FabLabKannai/fabbot/docs/img/fabbot_photo_top.jpg

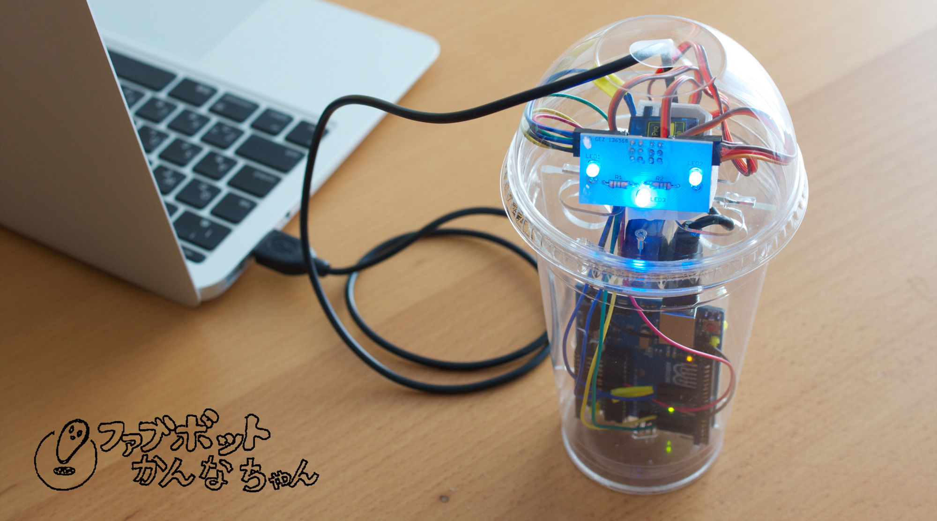
docs/img/fabbot_photo_top.jpg
