FabLabKannai/fabbot/frame/fabbot_frame_v3-1.pdf

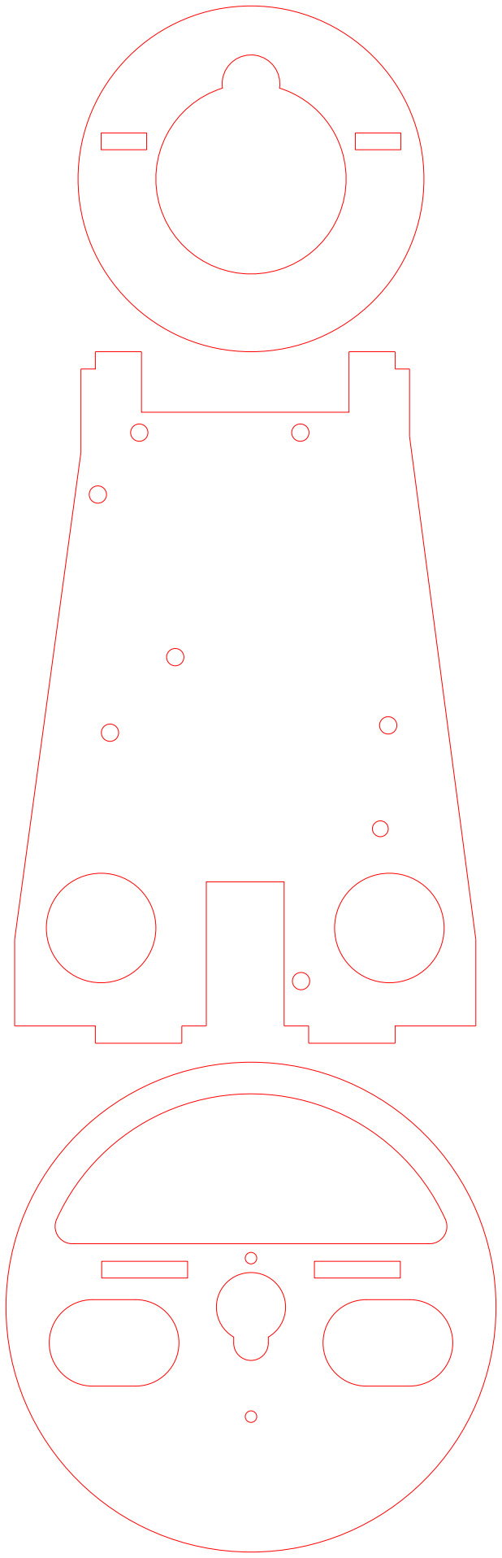
[picture p2: figure]
