FabLabKannai/fabbot/frame/fabbot_frame_v3.pdf

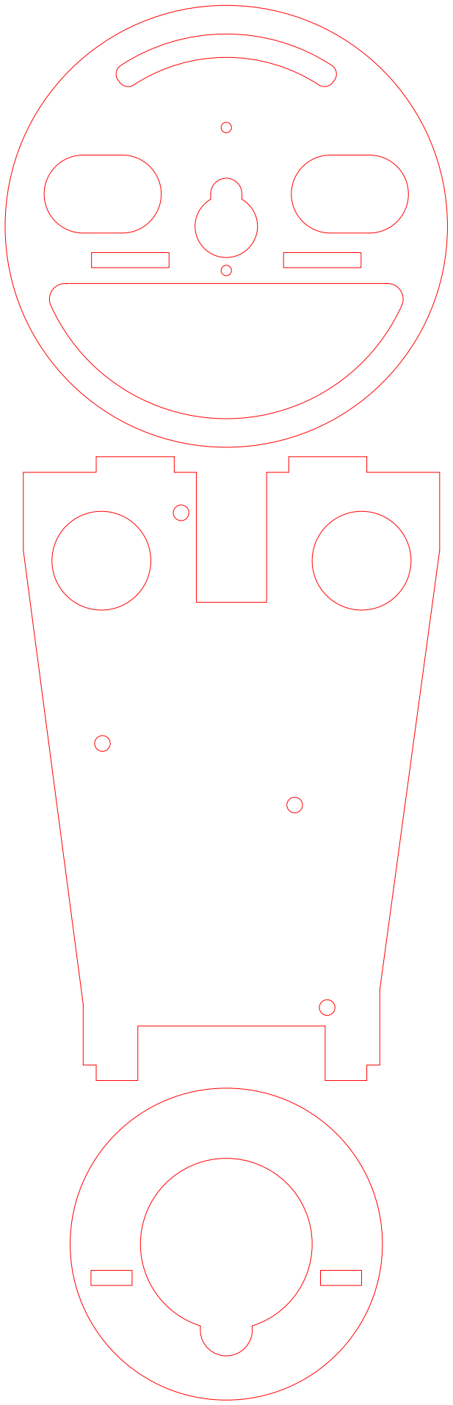
[picture p3: figure]
