FabLabKannai/fabbot/bracket/201412/bracket_for_replicator/bracket_A.stl

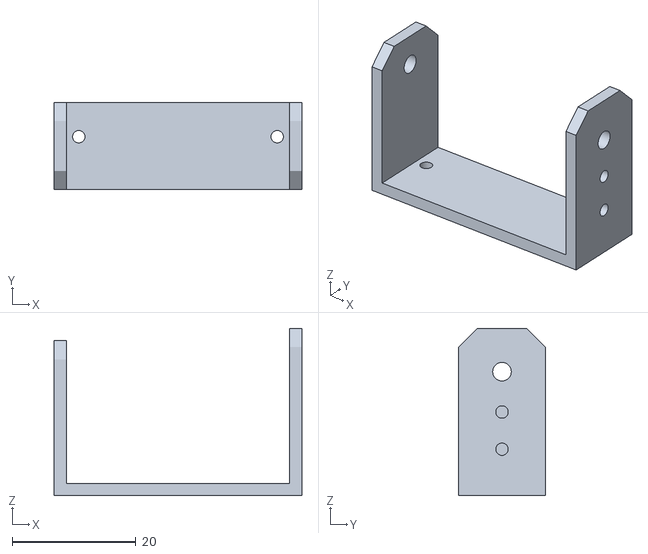
[picture p4: CAD file, 2014-11-28]
bracket/201412/bracket_for_replicator/bracket_A.stl
40.0 x 14.0 x 27.0
