FabLabKannai/fabbot/bracket/201505/speaker_case.stl

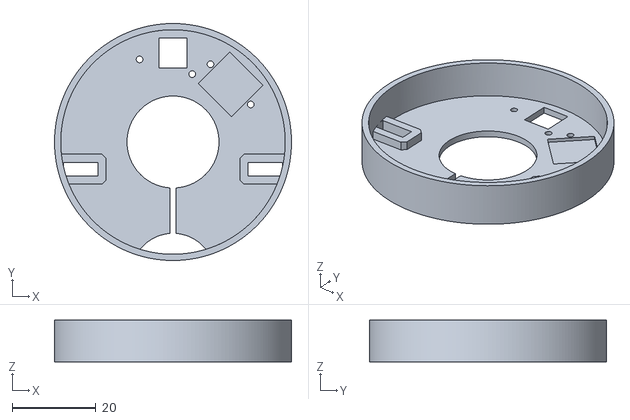
[picture p5: CAD file, 2015-05-09]
bracket/201505/speaker_case.stl
56.7 x 56.7 x 10.0
