FabLabKannai/fabbot/bracket/case.stl

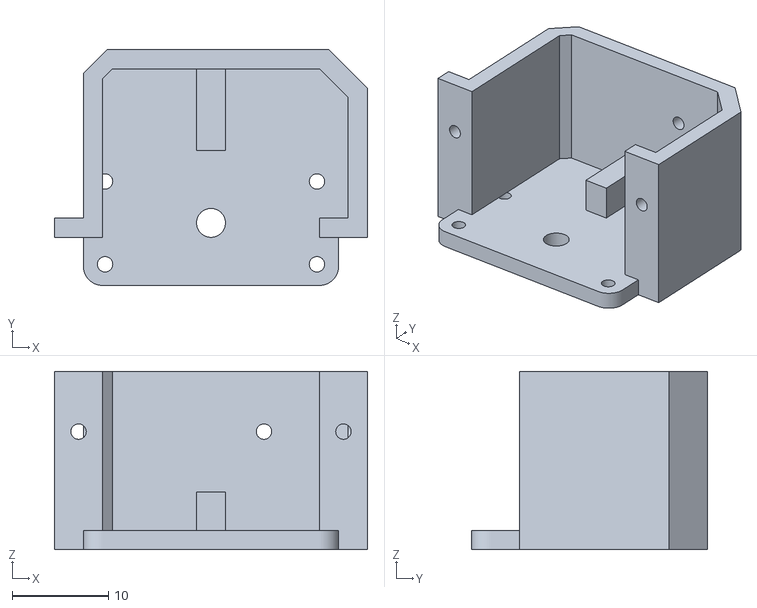
[picture p6: CAD file, 2015-09-20]
bracket/case.stl
32.5 x 24.5 x 18.5
