FabLabKannai/fabbot/speaker/speaker_case_L57ID_board.stl

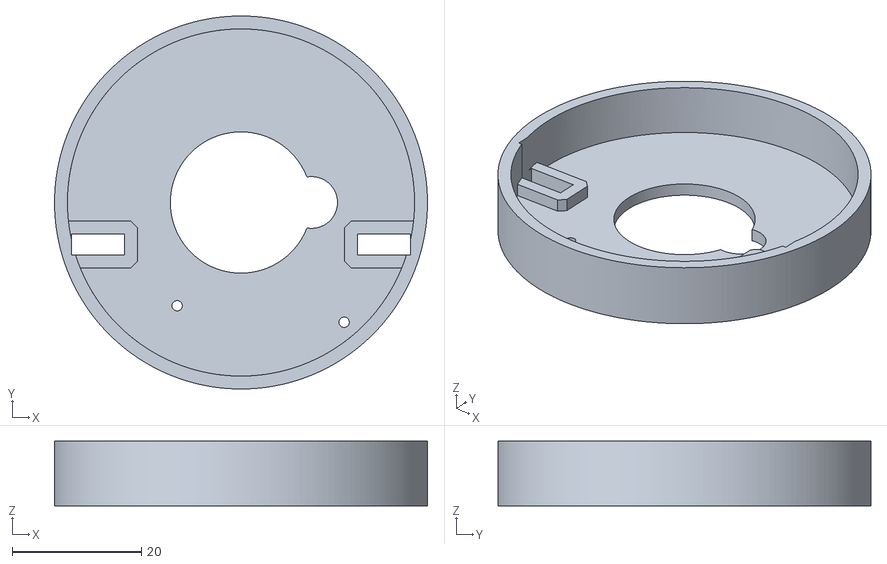
[picture p7: CAD file, 2015-09-20]
speaker/speaker_case_L57ID_board.stl
57.7 x 57.7 x 10.0
