FabLabKannai/fabbot/bracket/201412/bracket_for_replicator/bracket_B.stl

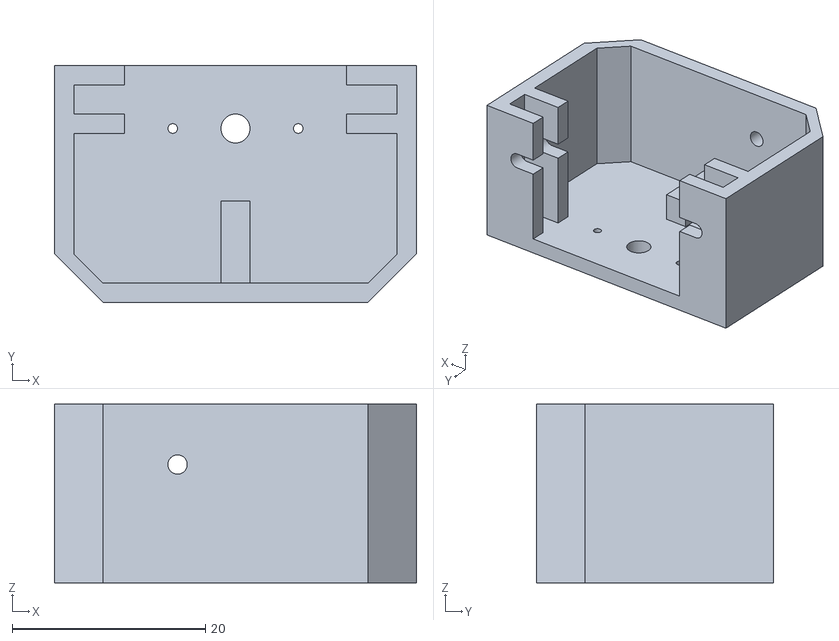
[picture p8: CAD file, 2014-11-28]
bracket/201412/bracket_for_replicator/bracket_B.stl
37.5 x 24.5 x 18.5
