FabLabKannai/fabbot/bracket/201508/case_rocket.stl

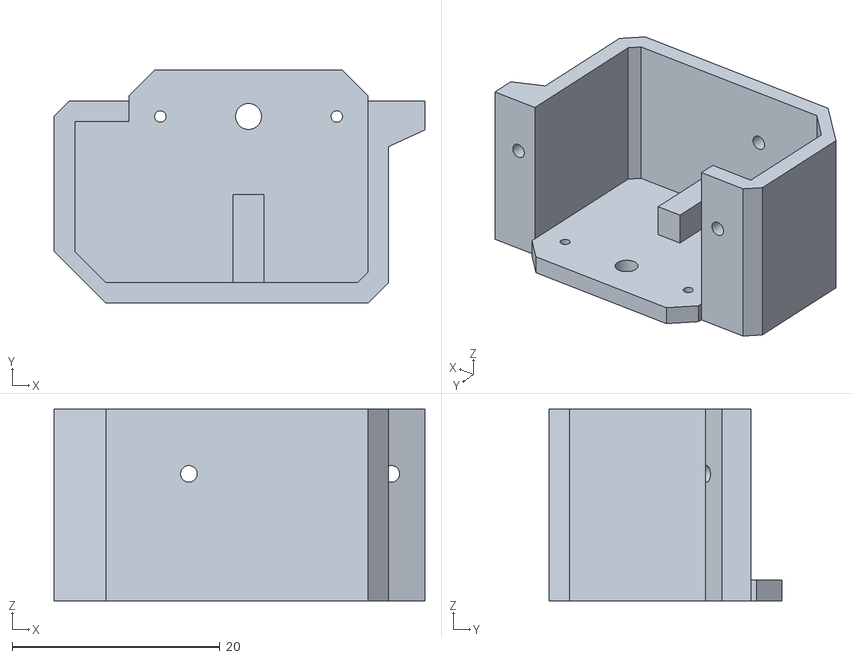
[picture p9: CAD file, 2015-09-16]
bracket/201508/case_rocket.stl
35.8 x 22.5 x 18.5
