FabLabKannai/fabbot/bracket/hornAdapter_face.stl

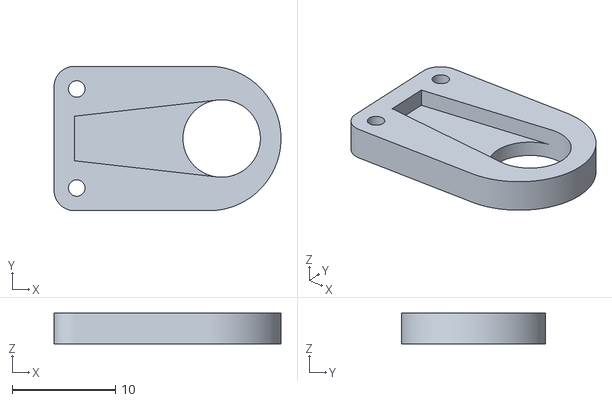
[picture p10: CAD file, 2015-09-20]
bracket/hornAdapter_face.stl
22.0 x 14.0 x 3.00
