FabLabKannai/fabbot/bracket/hornAdapter_case.stl

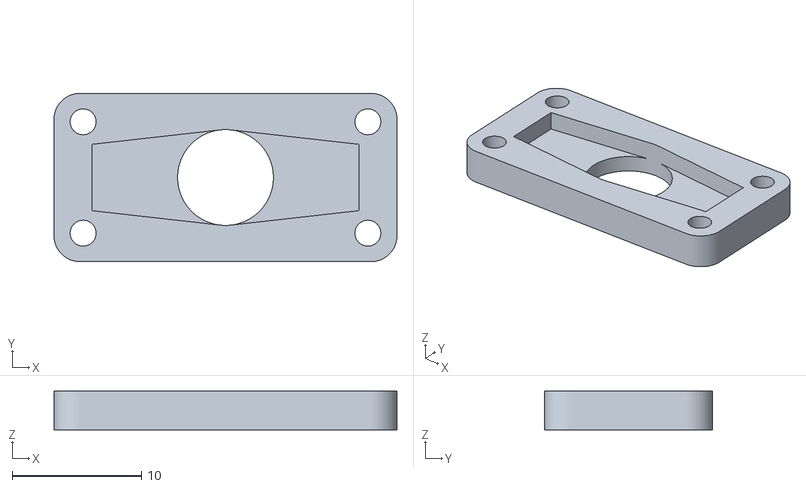
[picture p11: CAD file, 2015-09-20]
bracket/hornAdapter_case.stl
26.5 x 13.0 x 3.00
