FabLabKannai/fabbot/bracket/face.stl

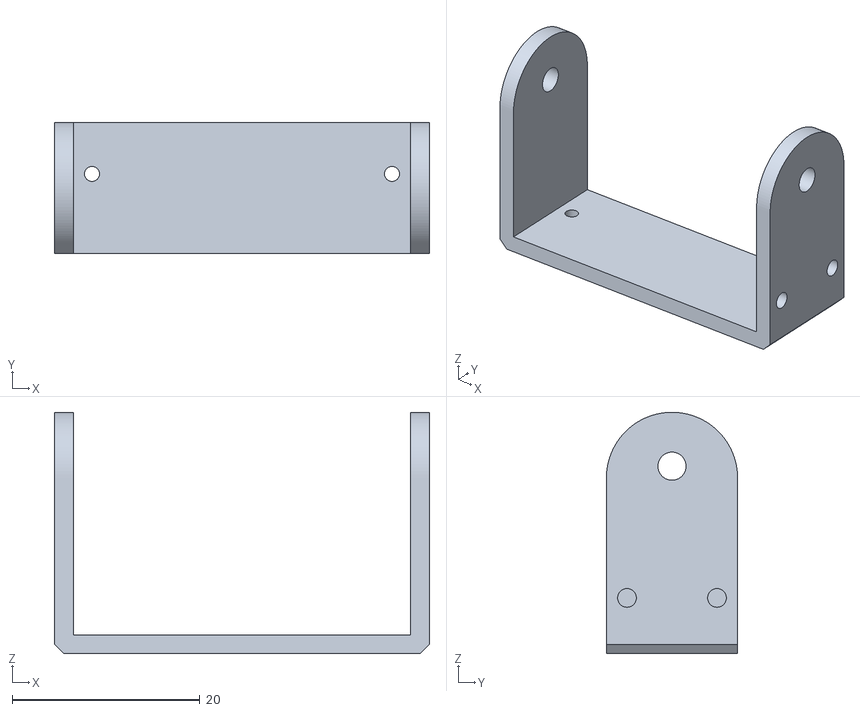
[picture p12: CAD file, 2015-09-20]
bracket/face.stl
40.0 x 14.0 x 25.7
