FabLabKannai/fabbot/bracket/old_version/201412/bracket_precise/case.stl

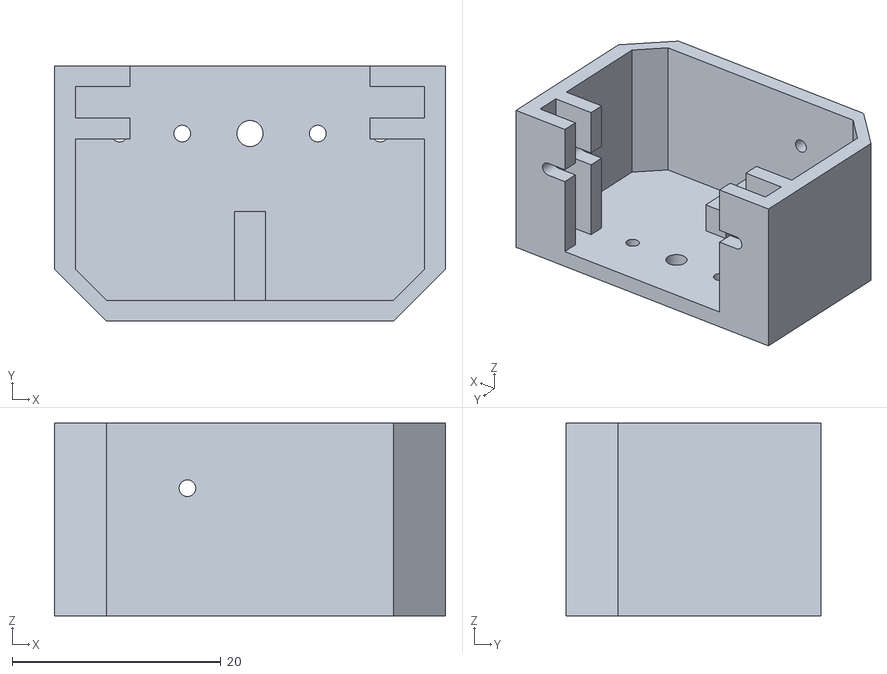
[picture p13: CAD file, 2014-12-26, an earlier design]
bracket/old_version/201412/bracket_precise/case.stl
37.5 x 24.5 x 18.5
