FabLabKannai/fabbot/bracket/old_version/201505/bracketB_case.stl

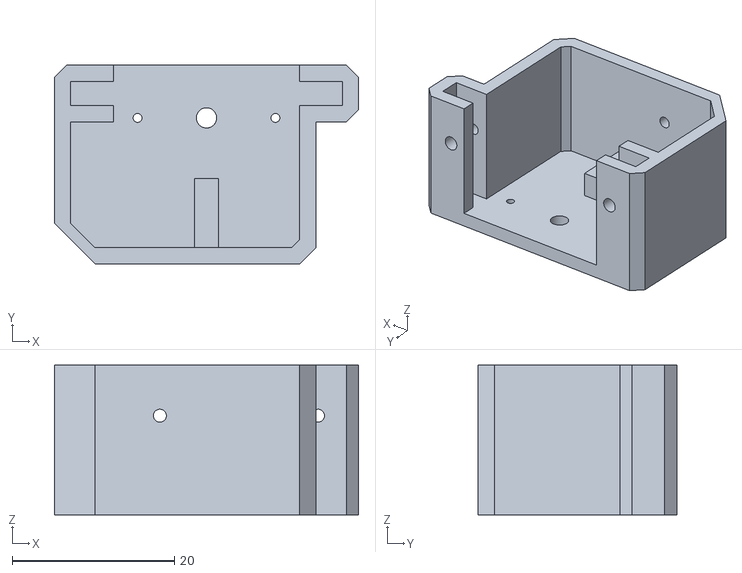
[picture p14: CAD file, 2015-05-09, an earlier design]
bracket/old_version/201505/bracketB_case.stl
37.5 x 24.5 x 18.5
