FabLabKannai/fabbot/(list of files, cad)

Other CAD files:
bracket/201508/face_rocket.stl
bracket/201412/bracket_precise/face.stl
bracket/old_version/201508/face_rocket.stl
bracket/old_version/201412/bracket_precise/face.stl
bracket/old_version/201505/bracketA_face.stl
