FabLabKannai/fabbot/docs/manual/fabbot_manual_v1.pdf

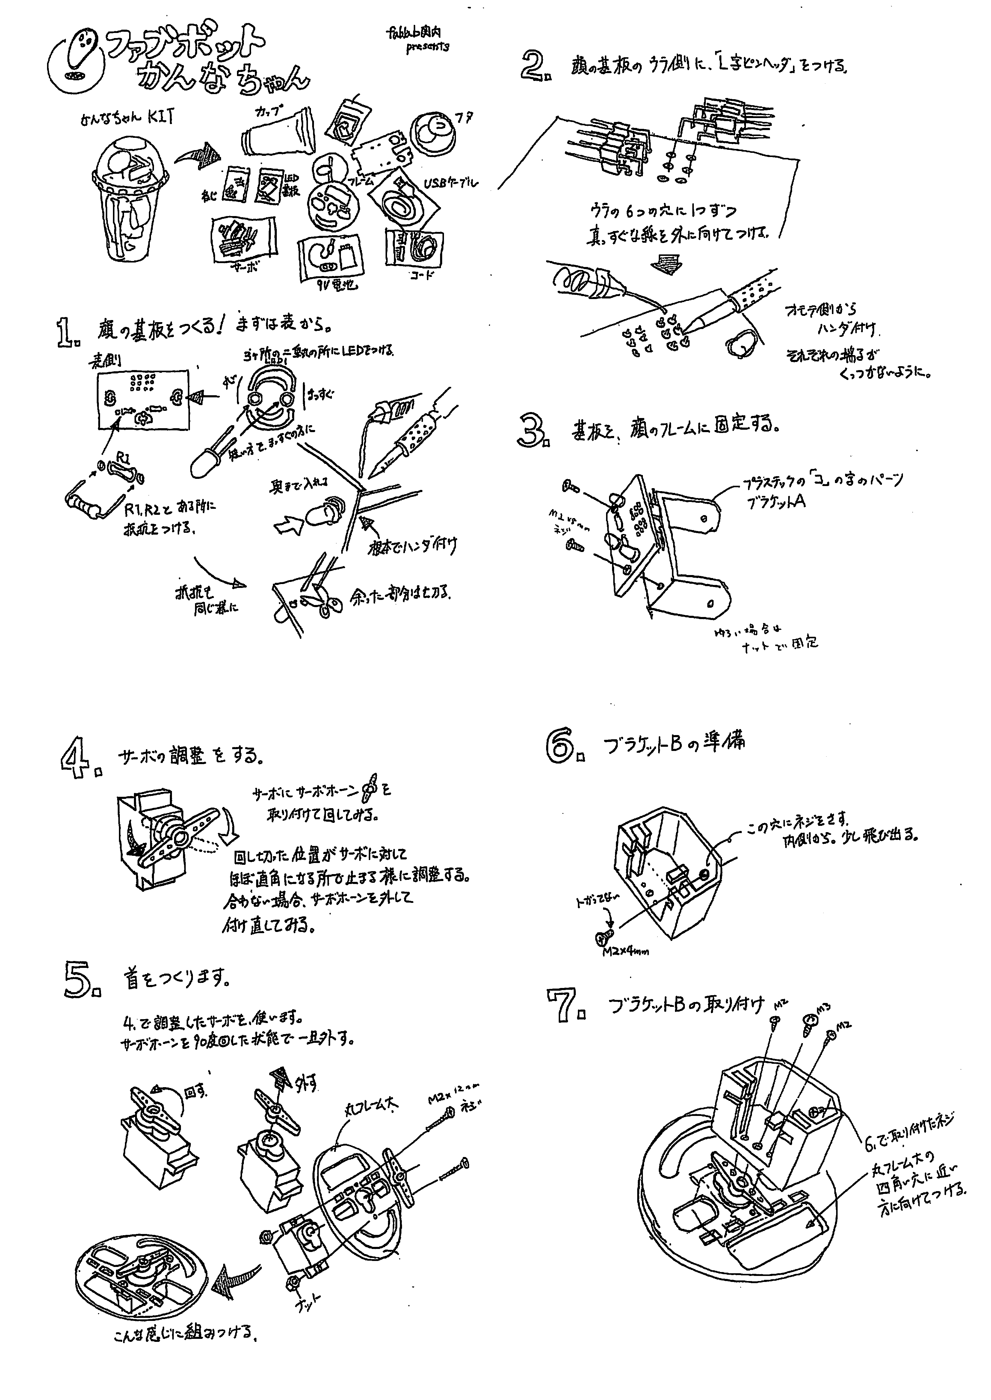
[picture p19: page 1]
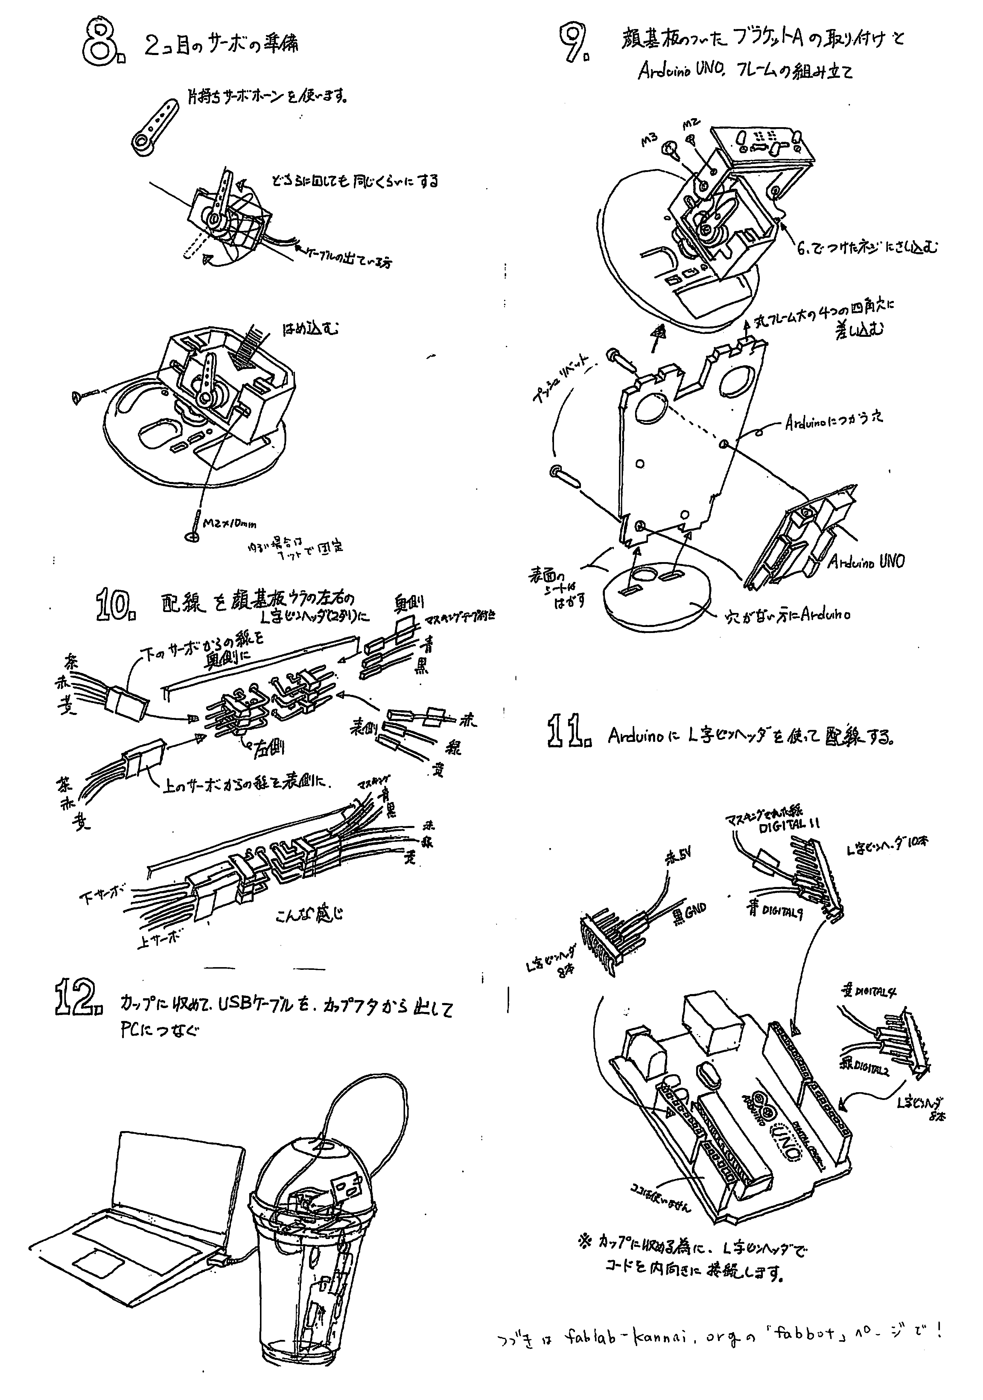
[picture p20: page 2]
