FabLabKannai/fabbot/docs/manual/old_version/manual_v2_A4_en.pdf

Adjust the position of Servomotor 1 (lower one).

Attach Servomotor 1 to round frame.

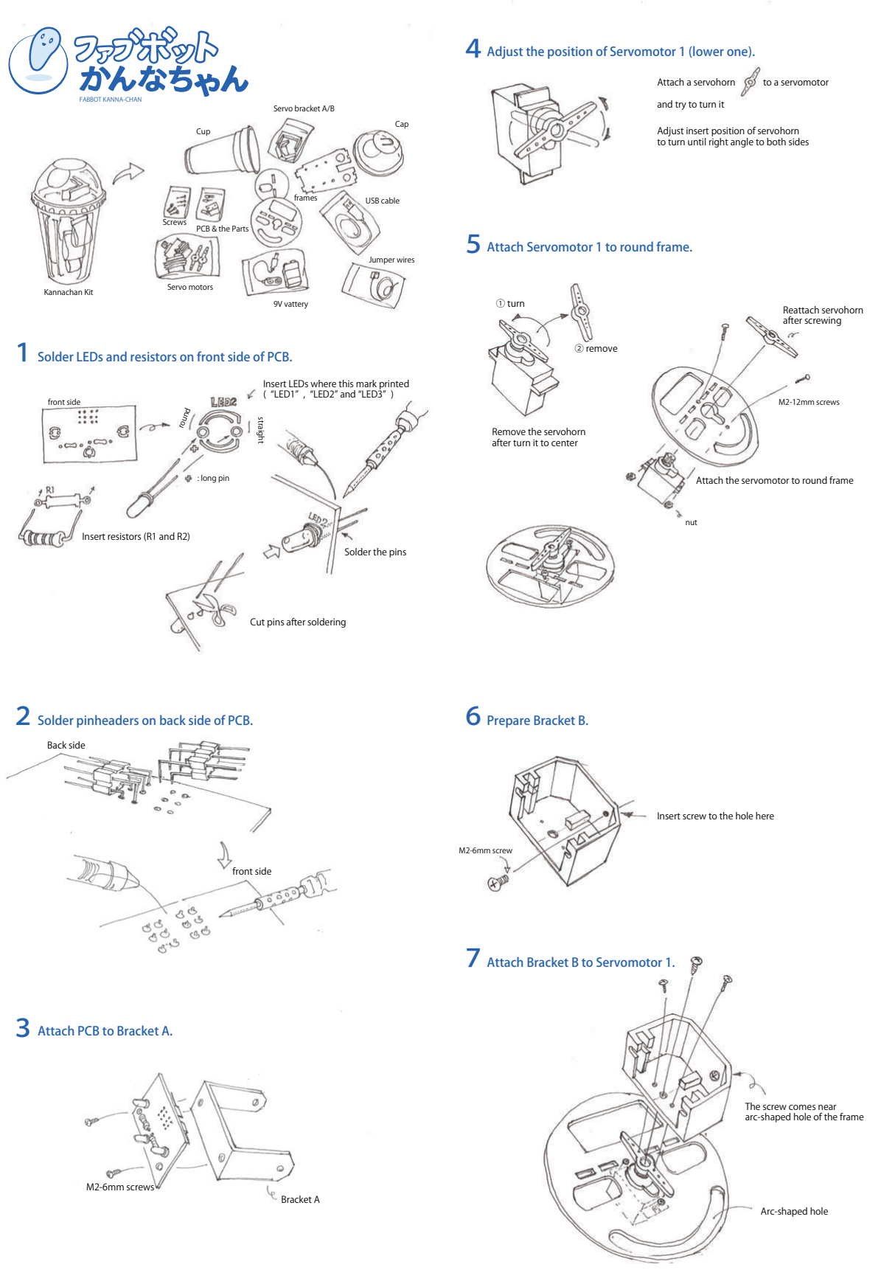
[picture p21: page 1]

１

Prepare Bracket B.

Attach Bracket B to Servomotor 1.

Insert screw to the hole here

M2-6mm screw

The screw comes near
arc-shaped hole of the frame

Arc-shaped hole

Attach a servohorn　　　to a servomotor and try to turn it
Adjust insert position of servohorn
to turn until right angle to both sides

① turn

② remove

nut

M2-12mm screws

Cup

Servo bracket A/B

frames

Cap

PCB & the Parts Screws

Servo motors Kannachan Kit

FABBOT KANNA-CHAN

9V vattery

USB cable

Jumper wires

Remove the servohorn
after turn it to center

Reattach servohorn
after screwing

Attach the servomotor to round frame

Back side

front side

M2-6mm screws

Solder pinheaders on back side of PCB.

Attach PCB to Bracket A.

Solder LEDs and resistors on front side of PCB.

Insert LEDs where this mark printed ( “LED1” , “LED2” and “LED3” ) front side

round

straight

Solder the pins

Cut pins after soldering

: long pin

Insert resistors (R1 and R2)

Bracket A

４

５

６

７

２

３

Connect cables to PCB.

Connect cables to Arduino.

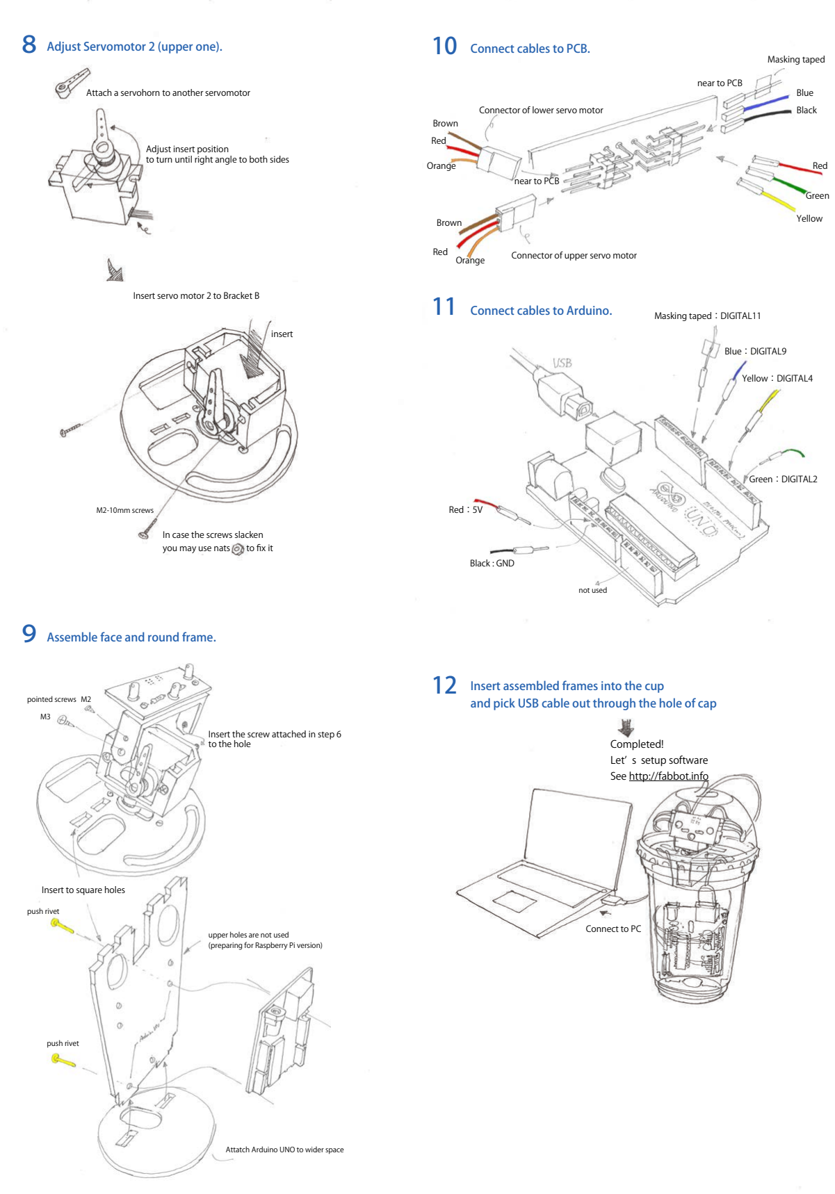
[picture p22: page 2]

M2-10mm screws

Connector of upper servo motor

Connector of lower servo motor

near to PCB

near to PCB
Blue
Black

Red

Green
Yellow

Brown
Red
Orange

Brown

Red
Orange

Masking taped

Masking taped：DIGITAL11

Blue：DIGITAL9

Red：5V

Black : GND

not used

Yellow：DIGITAL4

Green：DIGITAL2

## Insert assembled frames into the cup and pick USB cable out through the hole of cap

Completed!
Letʼ s setup software
See http://fabbot.info

Connect to PC

Assemble face and round frame.

Insert the screw attached in step 6 to the hole

Insert to square holes

Adjust Servomotor 2 (upper one).

Attach a servohorn to another servomotor

Adjust insert position
to turn until right angle to both sides

Insert servo motor 2 to Bracket B

In case the screws slacken you may use nats to fix it

insert

M3

pointed screws M2

push rivet

upper holes are not used
(preparing for Raspberry Pi version)

Attatch Arduino UNO to wider space

push rivet

８ | 10

11

12

９
