FabLabKannai/fabbot/docs/manual/old_version/manual_v2_A4_ja.pdf

## サーボの調整をする

## 首をつくる

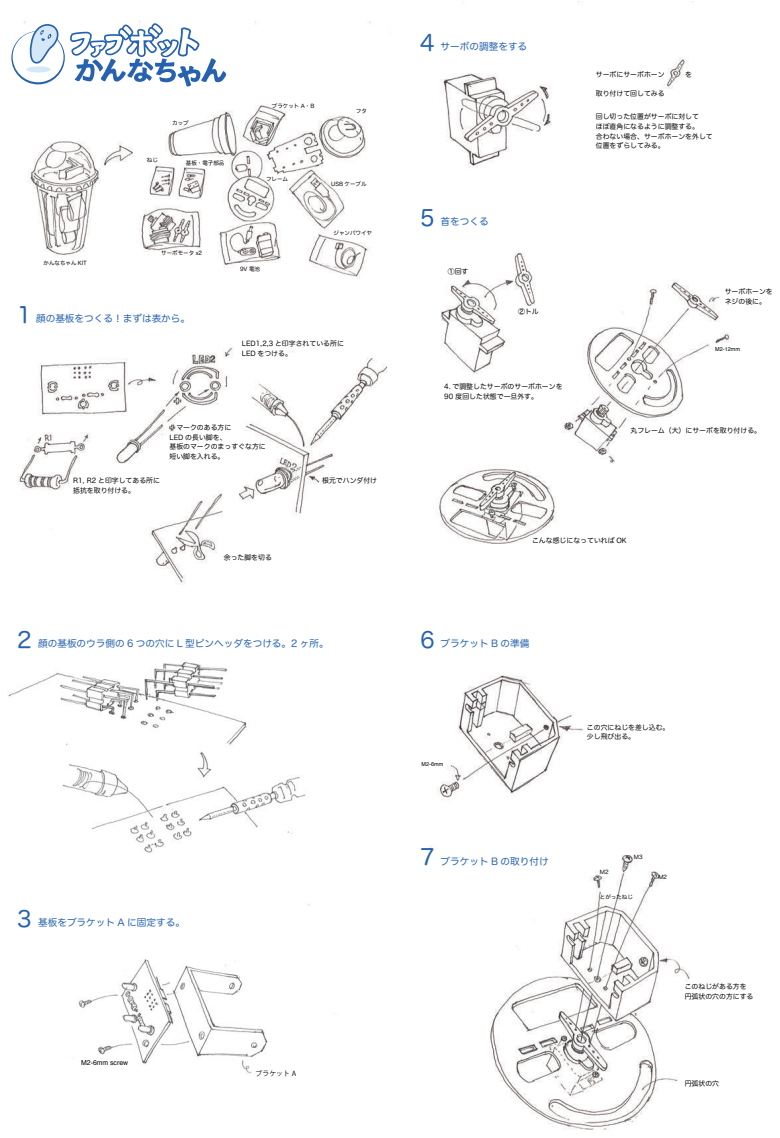
[picture p23: page 1]
ブラケット B の準備; ブラケット B の取り付け; この穴にねじを差し込む。 少し飛び出る。; このねじがある方を 円弧状の穴の方にする; 円弧状の穴; とがったねじ; サーボにサーボホーン を; 取り付けて回してみる; 回し切った位置がサーボに対して ほぼ直角になるように調整する。 合わない場合、サーボホーンを外して 位置をずらしてみる。; ①回す; ②トル; 4. で調整したサーボのサーボホーンを 90 度回した状態で一旦外す。; サーボホーンを ネジの後に。; 丸フレーム（大）にサーボを取り付ける。; こんな感じになっていれば OK; 基板をブラケット A に固定する。; 顔の基板をつくる！まずは表から。; LED1,2,3 と印字されている所に LED をつける。; 根元でハンダ付け; 余った脚を切る; マークのある方に LED の長い脚を、 基板のマークのまっすぐな方に 短い脚を入れる。; R1, R2 と印字してある所に 抵抗を取り付ける。; かんなちゃん KIT; カップ; サーボモータ x2; 基板・電子部品; ブラケット A・B; USB ケーブル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

顔の基板のウラ側の 6 つの穴に L 型ピンヘッダをつける。2 ヶ所。

## 基板のウラ、L 型ピンヘッダへの配線

## Arduino 上の指定の端子に各ケーブルを配線する

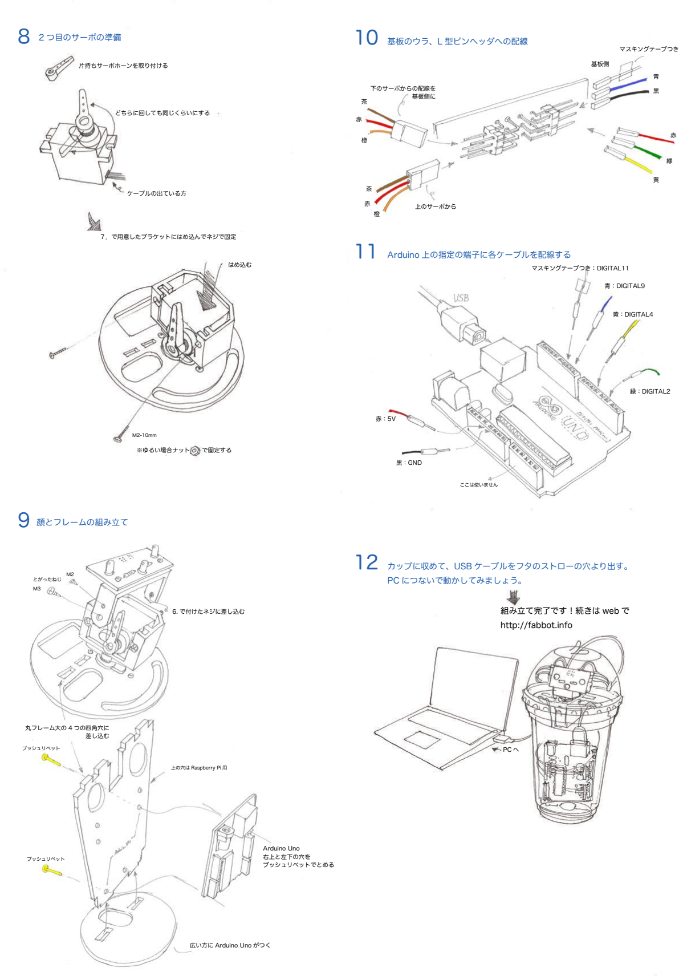
[picture p24: page 2]

下のサーボからの配線を
基板側に

上のサーボから

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
マスキングテープつき

マスキングテープつき：DIGITAL11

青：DIGITAL9

赤：5V

黒：GND

ここは使いません

黄：DIGITAL4

緑：DIGITAL2

## カップに収めて、USB ケーブルをフタのストローの穴より出す。 PC につないで動かしてみましょう。

## 組み立て完了です！続きは web で http://fabbot.info

PC へ

## 顔とフレームの組み立て

6. で付けたネジに差し込む

丸フレーム大の 4 つの四角穴に
差し込む

広い方に Arduino Uno がつく

Arduino Uno
右上と左下の穴を
プッシュリベットでとめる

## 2 つ目のサーボの準備

片持ちサーボホーンを取り付ける

どちらに回しても同じくらいにする

ケーブルの出ている方

※ゆるい場合ナット　　で固定する

M2-10mm

７．で用意したブラケットにはめ込んでネジで固定

はめ込む

M3

M2
とがったねじ

プッシュリベット

プッシュリベット

上の穴は Raspberry Pi 用

８ | 10

11

12

９
