FabLabKannai/fabbot/docs/manual/manual_v5_1_J.pdf

# １ 基板に部品をはんだづけする

「おもて」からさす部品 | 「うら」からさす部品

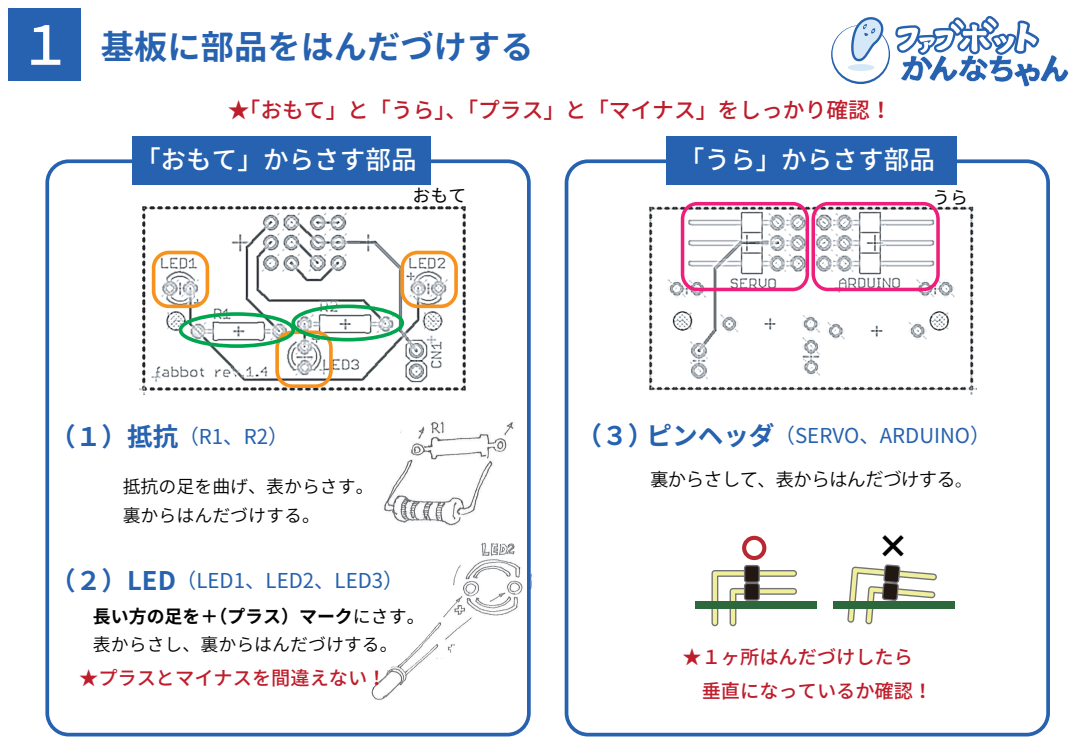
[picture p25: page 1]
（３） ピンヘッダ（SERVO、ARDUINO）; 裏からさして、表からはんだづけする。; ★１ヶ所はんだづけしたら 垂直になっているか確認！; おもて

★「おもて」と「うら」、「プラス」と「マイナス」をしっかり確認！

抵抗の足を曲げ、表からさす。
裏からはんだづけする。
（２）LED（LED1、LED2、LED3）
長い方の足を＋（プラス）マークにさす。
表からさし、裏からはんだづけする。
★プラスとマイナスを間違えない！

# ２ ブラケット A を組み立てる

## 1. ホーンカバー A のくぼみにサーボホーンをはめ込み、ネジ止めする

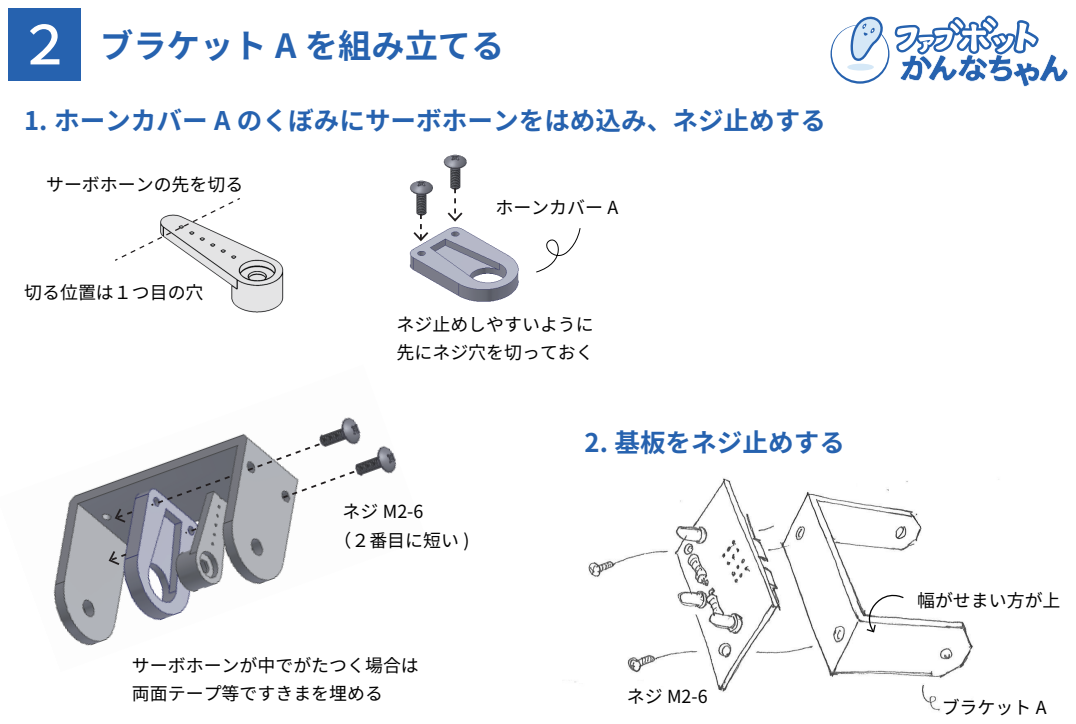
[picture p26: page 2]
幅がせまい方が上; サーボホーンの先を切る; 切る位置は１つ目の穴; サーボホーンが中でがたつく場合は 両面テープ等ですきまを埋める; ネジ止めしやすいように 先にネジ穴を切っておく; ブラケット A; 2. 基板をネジ止めする; ネジ M2-6 （２番目に短い ); ホーンカバー A

## 1. 内側からネジをとめる

# ３ ブラケット B を組み立てる

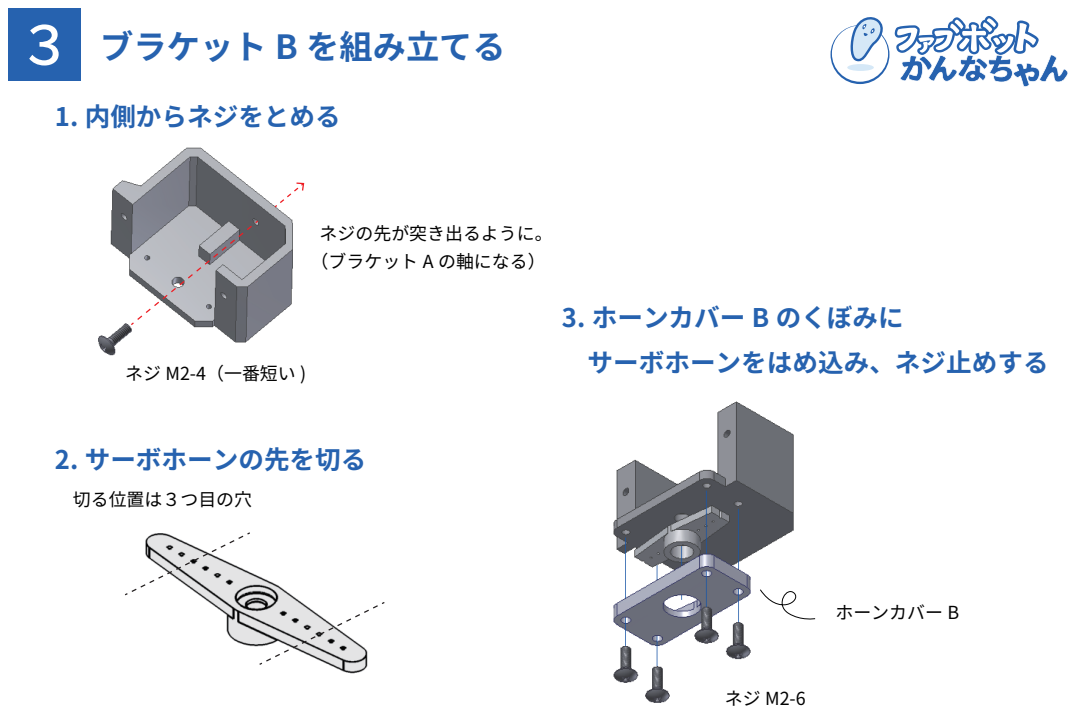
[picture p27: page 3]
ネジの先が突き出るように。 （ブラケット A の軸になる）; 切る位置は３つ目の穴; 2. サーボホーンの先を切る; 3. ホーンカバー B のくぼみに サーボホーンをはめ込み、ネジ止めする; ホーンカバー B; ネジ M2-4（一番短い )

## 1. サーボを丸フレーム（大）にネジ止めする

## 3. ブラケット B をネジ止めする

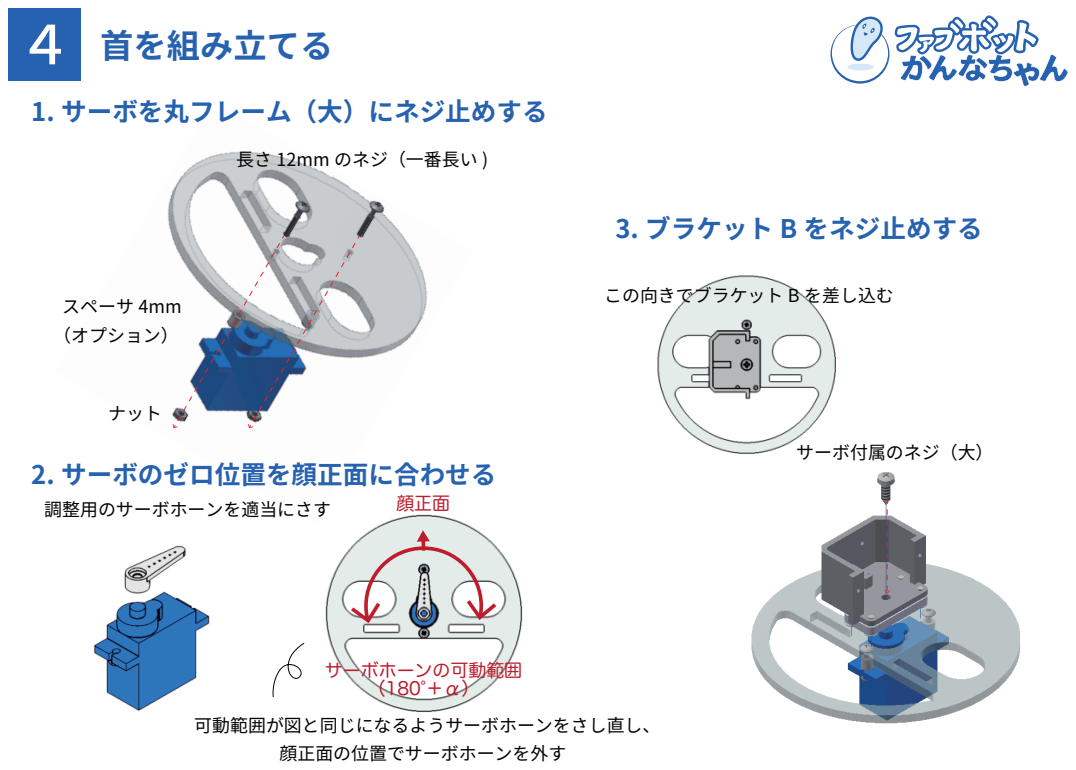
[picture p28: page 4]
2. サーボのゼロ位置を顔正面に合わせる; スペーサ 4mm （オプション）; ナット; ４ 首を組み立てる; 調整用のサーボホーンを適当にさす; サーボホーンの可動範囲 （180°＋α）; 顔正面; 可動範囲が図と同じになるようサーボホーンをさし直し、 顔正面の位置でサーボホーンを外す; この向きでブラケット B を差し込む; サーボ付属のネジ（大）

長さ 12mm のネジ（一番長い )

## 1.２つ目のサーボをブラケット B にネジ止めする

# ５ 頭を組み立てる

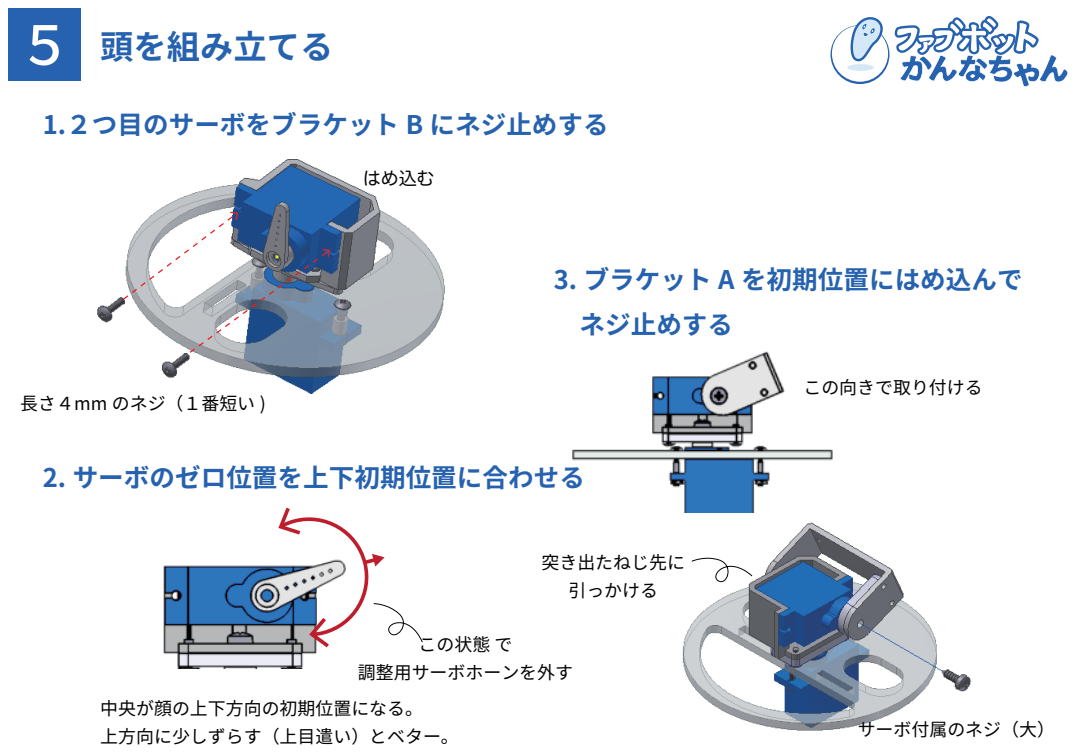
[picture p29: page 5]
2. サーボのゼロ位置を上下初期位置に合わせる; 3. ブラケット A を初期位置にはめ込んで ネジ止めする; サーボ付属のネジ（大）; 突き出たねじ先に 引っかける; この向きで取り付ける; はめ込む; 長さ４mm のネジ（１番短い ); この状態 で 調整用サーボホーンを外す

中央が顔の上下方向の初期位置になる。
上方向に少しずらす（上目遣い）とベター。

## アクリルフレームを組み立てて、Arduino をプッシュリベットでとめる

# ６ 体を組み立てる

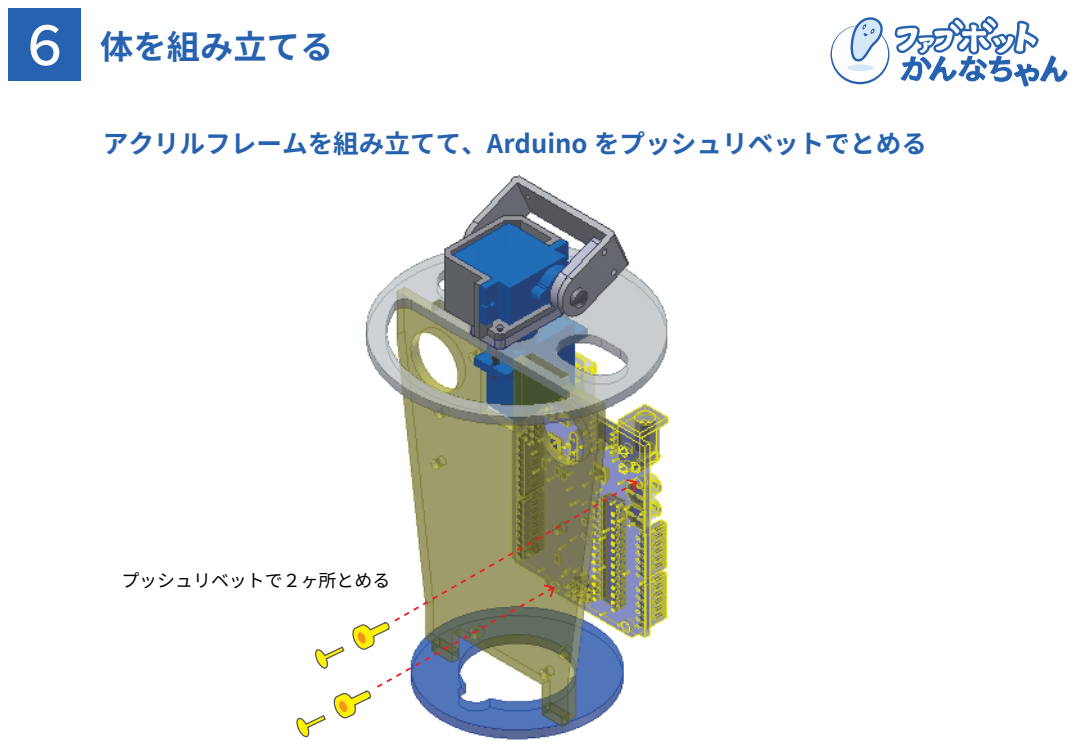
[picture p30: page 6]
プッシュリベットで２ヶ所とめる

## 基板のウラ、L 型ピンヘッダへの配線

# ７ 配線する

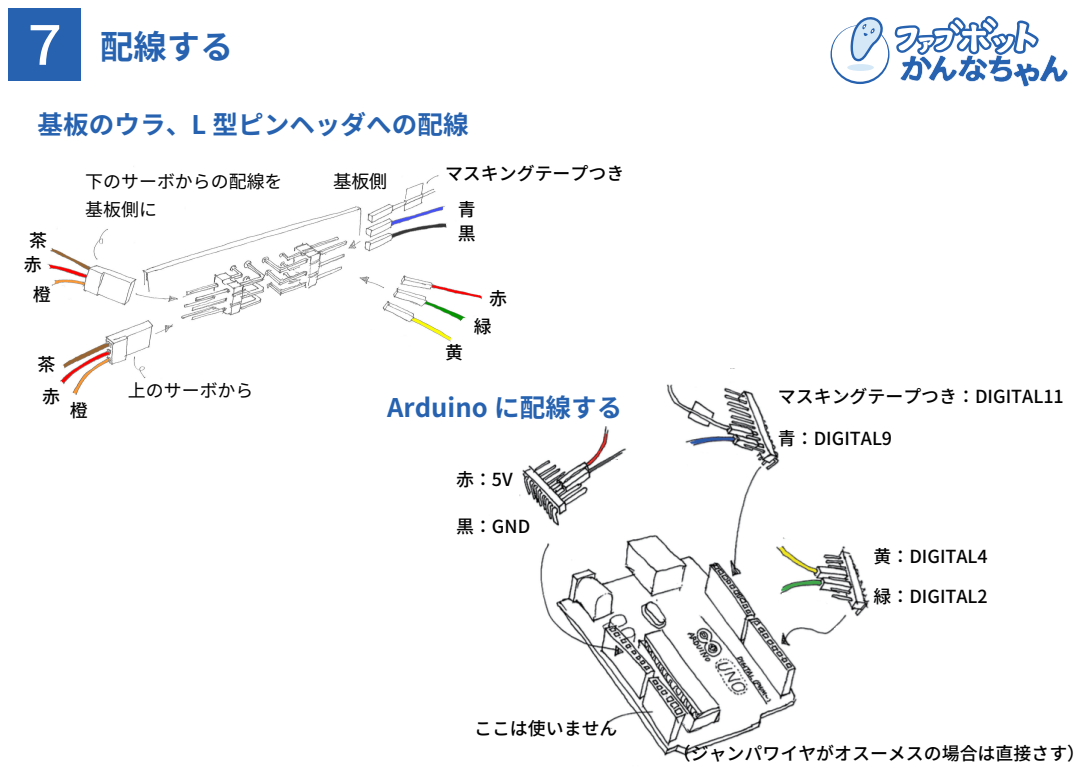
[picture p31: page 7]
Arduino に配線する; 下のサーボからの配線を 基板側に; 上のサーボから; 基板側; マスキングテープつき; マスキングテープつき：DIGITAL11; （ジャンパワイヤがオスーメスの場合は直接さす）; 青：DIGITAL9; 黄：DIGITAL4 緑：DIGITAL2; 黒：GND; ここは使いません

## カップに収めて、USB ケーブルをフタのストローの穴より出す。

# ８ 組み立て完了

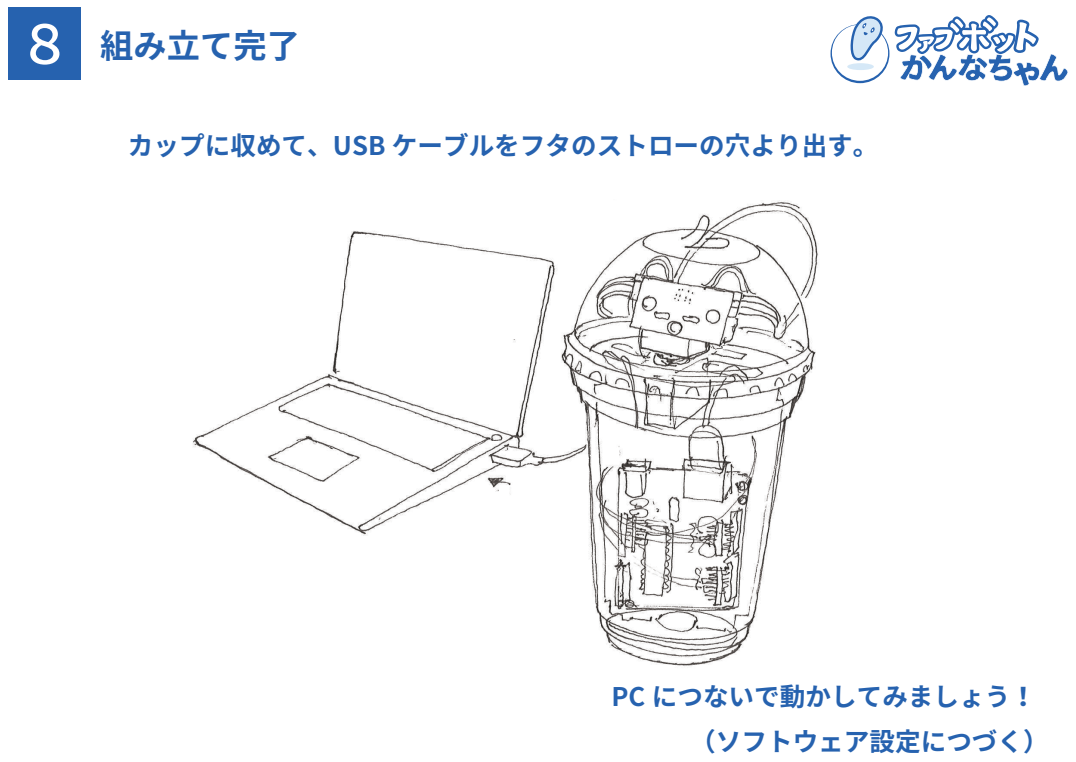
[picture p32: page 8]
PC につないで動かしてみましょう！ （ソフトウェア設定につづく）
