FabLabKannai/fabbot/frame/fabbot_frame_v2.pdf

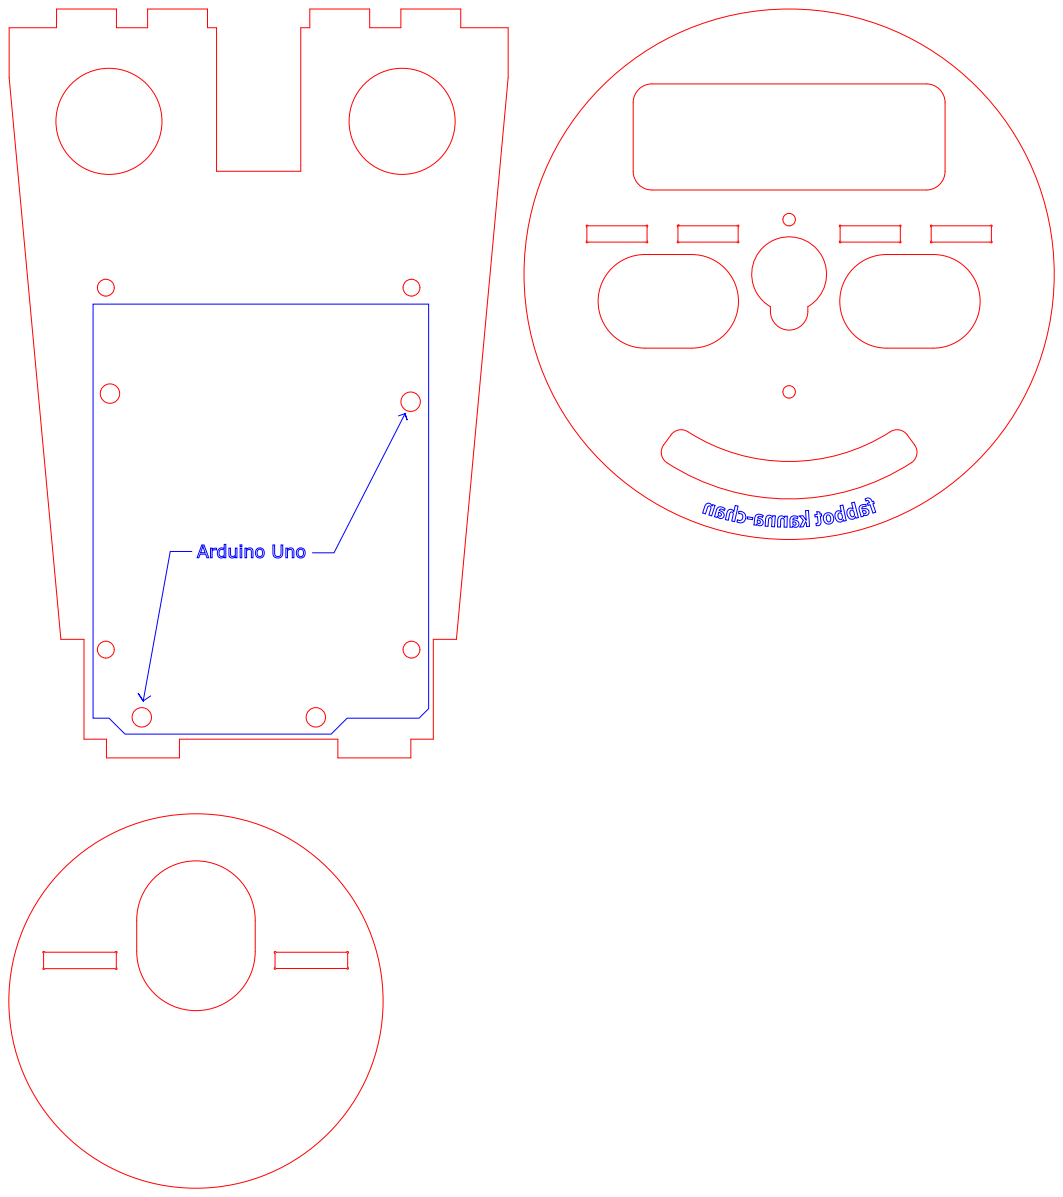
[picture p38: page 1]
