FabLabKannai/fabbot/PCB/fabbot_v14.brd

## EAGLE design PCB/fabbot_v14.brd (2015-11-16)

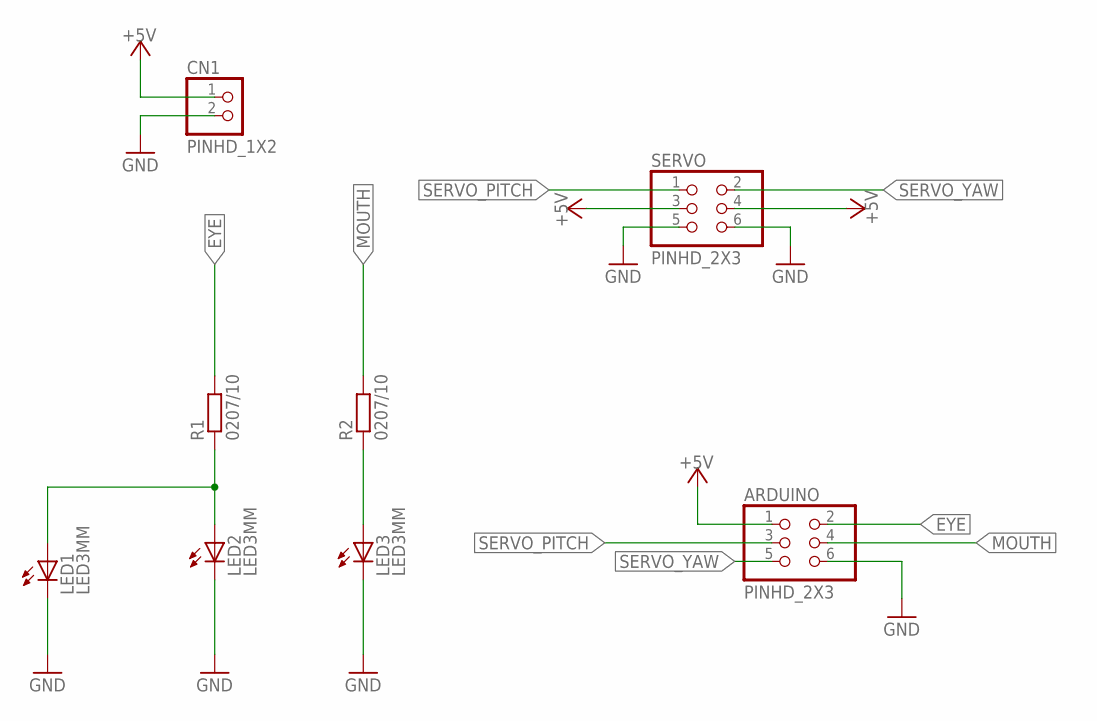
[picture p39: schematic fabbot_v14.sch]

Parts:
ARDUINO: PINHD_2X3; 2X03/90
CN1: PINHD_1X2; PINHEAD1X2
LED1, LED2, LED3: LED3MM
R1, R2: 0207/10
SERVO: PINHD_2X3; 2X03/90

Connections:
+5V: ARDUINO.1, CN1.1, SERVO.3, SERVO.4
EYE: ARDUINO.2, R1.2
GND: ARDUINO.6, CN1.2, LED1.K (C), LED2.K (C), LED3.K (C), SERVO.5, SERVO.6
MOUTH: ARDUINO.4, R2.2
unnamed: LED1.A, LED2.A, R1.1
unnamed: LED3.A, R2.1
SERVO_PITCH: ARDUINO.3, SERVO.1
SERVO_YAW: ARDUINO.5, SERVO.2

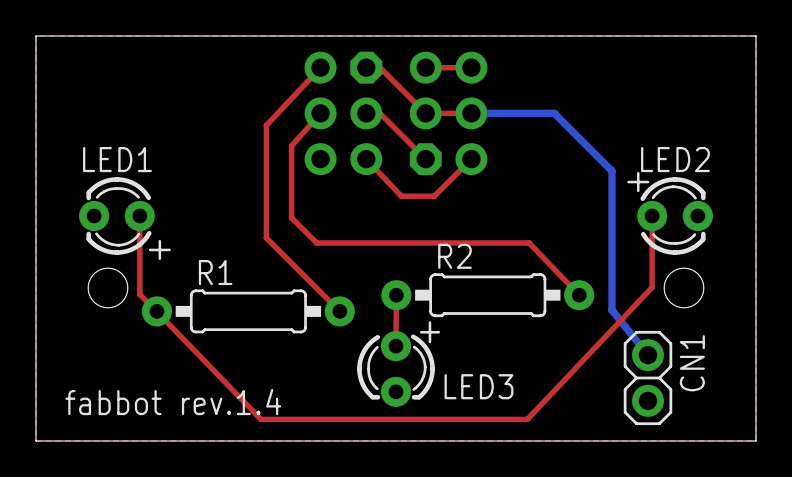
[picture p40: board fabbot_v14.brd from above]

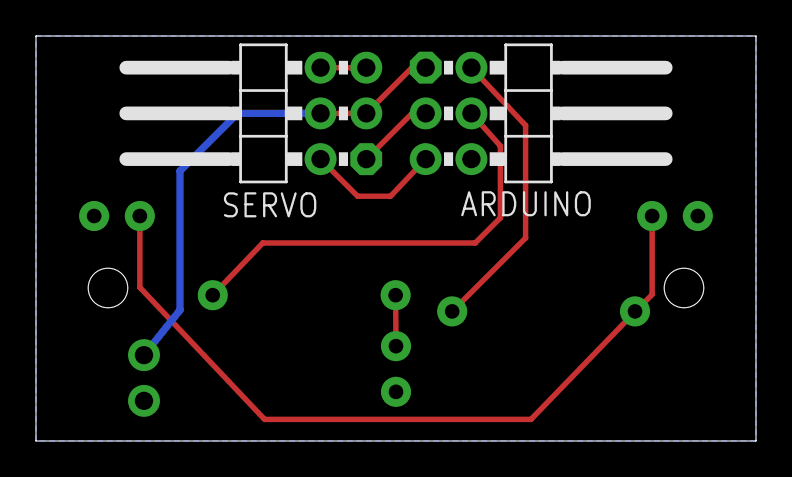
[picture p41: board fabbot_v14.brd from below]

Board: 2 copper layers, 40.0 x 22.5 mm, 8 parts (2 on the bottom side), 8 nets.
