FabLabKannai/fabbot/(commit log)

2014-11-28 first version
    [bracket_A.stl, bracket_B.stl, fabbot_20141102.brd, fabbot_20141102.sch, fabbot_frame.dwg]
2014-12-26 for precise 3Dprinting
    [bracket_A.stl, bracket_B.stl, case.ipt, case.stl, face.ipt, face.stl]
2015-01-17 place guide added
    [fabbot_frame_v2.dwg]
2015-01-17 place guide modified
    [fabbot_frame_v2.dwg]
2015-05-09 +raspi version
    [bracketA_face.stl, bracketB_case.stl, bracket_A.stl, bracket_B.stl, case.ipt, case.stl, fabbot_frame.dwg, face.ipt]
2015-09-20 raspi version
    [speaker_case_L57ID_board.stl]
2015-10-07 create old version directory
    [fabbot_frame.dwg]
2015-10-07 create old_version directory
    [bracketA_face.stl, bracketB_case.stl, bracket_A.stl, bracket_B.stl, case.stl, case_rocket.stl, face.stl, face_rocket.stl]
2015-11-16 update eagle data
    [fabbot_20141102.brd, fabbot_20141102.sch, fabbot_v14.brd, fabbot_v14.sch]
